JEJacobi/divchrono/doc/encoder.odt

Encoder Board

Simple board mounted forwards on the front side of the case, four mounting holes with standoffs to sit right up against the case. Rotary switch at the center. Seven positions, which are encoded into 3 bits of data using a SN74HC148DR.

Output Specification:

P1 | P2 | P3 | P4 | P5 | P6 | P7 | D1 | D2 | D3
1 / ? | 1 / ? | 1 / ? | 1 / ? | 1 / ? | 1 / ? | 1 / ? | 1 | 1 | 1
1 | 1 | 1 | 1 | 1 | 1 | 0 | 0 | 0 | 0
1 | 1 | 1 | 1 | 1 | 0 | 1 | 1 | 0 | 0
1 | 1 | 1 | 1 | 0 | 1 | 1 | 0 | 1 | 0
1 | 1 | 1 | 0 | 1 | 1 | 1 | 0 | 0 | 1
1 | 1 | 0 | 1 | 1 | 1 | 1 | 1 | 1 | 0
1 | 0 | 1 | 1 | 1 | 1 | 1 | 1 | 0 | 1
0 | 1 | 1 | 1 | 1 | 1 | 1 | 0 | 1 | 1

P 1, 2, 3, 4, 5, 6, 7: Inputs from the rotary switch, corresponding to the seven possible connected states.

?: Unknown state, or no valid reading from the rotary switch (such as the switch being disconnected while in travel).

D1, D2, D3: Encoded output data, fed to the raspi for mode processing.
