JEJacobi/divchrono/doc/cables.odt

Cables

Case:

- RASPI to MASTER: 2x13 pin female to female, see BOM.
- MASTER to DISPLAY: 2x6 pin IDC ribbon cable for data. Copy off of Titor’s design, add four pins for pushbutton feedback (pulled up to 3.3v on the master board).
- MASTER to ENCODER: 2x3 pin ribbon cable, standard AVR programming style 2x3 headers. D1, D2, D3, +3.3v, GND. One pin unused.

External:

- 12V POWER to CASE: Standard barrel jack connector to provide main power to case.
- 12V POWER to AMPLIFIER: Splitter off of the 12V power supply will power the external amplifier.
- RASPI AUDIO to AMPLIFIER: A 3.5mm port at the back of the case will connect to the external amplifier.
- AMPLIFIER to SPEAKERS or TRANSDUCERS: The 3.5mm or terminal block output ports on the external amplifier will connect to any desired audio sinks.
