JEJacobi/divchrono/doc/display.odt

Display

The upper display board contains eight IN-14 nixie tubes, as well as three HV5622 driver chips. A ribbon cable provides +170VDC, +12VDC, GND * 2, DAT, CLK, LAT, and BLANK connections, along with four contacts for the four pushbuttons mounted at the top of the case.

The original schematic of this board is based on seems to contain an error, as the HV5622 chips’ recommended logic voltage is between 10.8V and 13.2V. The schematic shows a logic supply voltage of +5VDC, and a connection directly to the 5V powered microcontroller.

This version of the HV5622 signals will have a single direction 3.3V → 12V level converter, with a 3904 connected to the Pi via a 10k current limiting resistor, and a 10k pull-up resistor. On the other end, a 4.7k holds the data lines high, with the Pi pulling them to ground by sinking the signal transistor’s pull-up.

The four pushbuttons at the top of the case are pulled down to ground by a press, and are normally pulled up high with 10k resistors on the master board.

Dimming will be accomplished through software PWM on the blanking pin.
