JEJacobi/divchrono/doc/pins.odt

Pin Mapping

Name | Description | Pin | BCM Port
STATUS_DAT | Status LEDs’ shift register data pin. | 11 | 17
STATUS_CLK | Status LEDs’ shift register clock pin. | 13 | 27
STATUS_LAT | Status LEDs’ shift register latch pin. | 7 | 4
DISPLAY_DAT | Display board Nixie shift registers’ data pin. | 16 | 23
DISPLAY_CLK | Display board Nixie shift registers’ clock pin. | 18 | 24
DISPLAY_LAT | Display board Nixie shift registers’ latch pin. | 10 | 15
DISPLAY_BLANK | PWM brightness control pin for the Nixie tube display. | 12 | 18
BUTTON_LEFT | Status of the ‘<’ pushbutton, active low. | 15 | 22
BUTTON_RIGHT | Status of the ‘>’ pushbutton, active low. | 19 | 10
BUTTON_UP | Status of the ‘+’ pushbutton, active low. | 21 | 9
BUTTON_DOWN | Status of the ‘-’ pushbutton, active low. | 23 | 11
ENCODER_D1 | Pin #1 for the encoded position of the main rotary switch. | 22 | 25
ENCODER_D2 | Pin #2 for the encoded position of the main rotary switch. | 24 | 8
ENCODER_D3 | Pin #3 for the encoded position of the main rotary switch. | 26 | 7

Sources:

- https://pinout.xyz
- https://www.raspberrypi.org/documentation/hardware/raspberrypi/schematics/Raspberry-Pi-Rev-2.1-Model-AB-Schematics.pdf
