JEJacobi/divchrono/doc/power.odt

Power Management

Main board power is provided through a board mounted barrel connector on the far left side of the unit. It inputs 12VDC from a T1116-P5P (or similar) power supply unit. The 12VDC is used directly by the audio amplifier module, and is also fed into two other power management modules for logic step-down, and Nixie tube step-up.

The 12VDC is stepped down to 5VDC through a TI TPS562200DDCR switching buck converter, capable of handling up to 2A. The Raspberry Pi will consume around 1.4A given its fairly light load of USB modules, and the rest of the logic circuits should use less than 100mA combined, giving a 25% power safety margin. See datasheet for example circuit, and schematic for exact parts and layout.

To provide high voltage DC for the Nixie tubes, the 12VDC is also fed into the ‘1364 - SmartNixie HVPS-H’ module, which provides up to 8 watts of power given 12V in. This module is mounted on the master board.
