JEJacobi/divchrono/doc/status.odt

Status LEDs

Name | Description | Number
PWR | Enabled at program startup, signals that the Pi’s software is running. | 0
HEARTBEAT | LED is toggled every second to indicate that the software is in working order. If something locks up or the software crashes, this will stop blinking. | 1
RTC OK | Enabled if good data and checksums are received from the Real Time Clock on the auxiliary board. | 2
NTP OK | Enabled if NTP (clock synchronization) server can be reached. | 3
NET OK | Enabled if the internet can be reached (ping results?). | 4
ALARM | Enabled if the ALARM mode is set. | 5
AUDIO | Enabled if the Pi is currently playing audio. | 6
UNUSED | Currently not used. | 7
