JEJacobi/divchrono/doc/amplifier.odt

Amplifier Board

Due to the Raspi’s analog audio out being a very weak audio source (since it’s just PWM filtered through a low-pass filter), audio output will be buffered through this board before being fed into speakers or transducers.

The amplifier is a simple 5x5cm PCB with a 12V barrel port, a 3.5mm audio in port, a 3.5mm audio out port, and a 3 pin terminal block for directly wiring to speakers.

The amplifier has a small gain trim potentiometer, but any real amplification should be done further down the signal path. Additionally, the amplifier has a 2 pin shunt that, when closed, will play mono audio (in case only one speaker is connected).
