JEJacobi/divchrono/doc/master.odt

Master Board

The master board is a large (10x10?) board that acts as the supervisor for the Raspi, Display, Auxiliary, and Encoder boards. It contains two power supply modules (see Power) that step 12VDC to 5VDC and 170VDC. The board also has a 8 LED status readout (see Status) at the back of the case, cable jacks for connections to the Raspi, Display, and Encoder boards.

See each section’s documentation for more detail.
