JEJacobi/divchrono/doc/auxiliary.odt

Auxiliary Board

The auxiliary board is a small (5x5cm) board that sits directly on top of the raspi’s GPIO header, and provides a stacking connection to the master ↔ raspi ribbon through an extra-long female header. Power and data lines are shared with the raspberry pi, and it requires no external connections.

The board has four main sections, the RTC IC, a 4 pin I2C jack for an HTU21D temperature/humidity sensor breakout board, a CR2032 battery holder, and two status lights for the RTC/battery status.

The PCF85263AT/AJ RTC provides an I2C-connected battery-backed real time clock to the raspberry pi, either as a primary time source or as a fallback if NTP fails. It has a status LED connected to it, which can function in a variety of modes depending on the INTA pin configuration.

Additionally, a comparator provides a low-voltage battery warning should the backup battery fall below 2.5 volts. This is fed to the LOW BATTERY status LED.
