JEJacobi/divchrono/doc/modes.odt

Master Modes

The seven position rotary switch allows the selection of seven different modes. Each mode assigns different functions to the four pushbuttons located at the top of the unit. The raspberry pi handles all processing and logic functions for the modes.

Mode details, in clockwise order beginning from the bottom leftmost position:

POSITION 1: OFF

The clock is shut off. The board and raspi remain powered on, but the nixie tubes are shut down, and no sound is played. The pushbuttons are not mapped to anything in this mode.

POSITION 2: CLOCK

The nixie tubes are enabled and display the current time in either 12/24 hour mode, depending on the configuration file’s setting. The pushbuttons change the display between current time, day of week, and day/month/year.

POSITION 3: ALARM

Identical to the previous mode, but a daily alarm is enabled at a stored time. When the time is reached, a random audio track is played out of a folder, and continues until this mode is disabled. The +/- pushbuttons set the alarm time, and the </> pushbuttons set the specified volume percentage in steps of 10%. A change to the alarm time will change the tubes to display this new value for a few seconds, before reverting to the 24 hour time. Similarly, a change to the volume will display the new percentage for a few seconds before reverting.

POSITION 4: DIVERGE

???

POSITION 5: MUSIC

In this mode, the tubes display the currently selected track, and the total number of valid tracks in the folder. Similarly to the alarm mode, the </> sets the volume, and +/- controls the currently selected track. Tracks play sequentially, and loop until the mode is disabled. A change in volume will momentarily change the display to reflect the new setting, as in ALARM mode.

POSITION 6: STATUS

In this mode, the tubes display the varying statuses:

- Current ambient temperature.
- Current ambient humidity.
- Uptime in seconds.
- Current IP, if connected.
- MAC address.

POSITION 7: EDIT

This mode lets you set the currently active date and time. </> control the active setting, and +/- change the value. The longer +/- are held, the more the value changes.

Settings:

- Seconds
- Minutes
- Hours
- Day of month
- Month
- Year
- Timezone
- DST (?)
