JEJacobi/divchrono/hw/divchronoBOM_rev1.ods

Divergence Chronometer BOM
Ref | Value | Footprint | Notes
MAIN BOARD
C1 | 100uF | E2,5-6
C2 | 470uF | E2,5-6
C3, C6, C9, C10, C12, C13 | 100nF | C1206
C4 | 10uF | E2-5
C5 | 10uF | C1206
C7, C8 | 22uF | C1206
C11 | 330uF | E3,5-8
D1, D2, D3, D4, D5, D6, D7, D8 | LTST-C230KRKT | LED1206
J1 | PJ-202AH | SPC4077
J2 | PINHD-2X13 MALE | 2X13
J3 | PINHD-2X6 MALE | 2X06
J4 | PINHD-2X3 MALE | 2X03
JP1 | PINHD-1X2 MALE | 1X02
L1 | 4.7uH | BS11
Q1, Q2, Q3, Q4 | BSS138 | SOT23-3
R1, R6, R7, R8, R9, R18, R19, R20, R21, R22, R23, R24, R25 | 10k | R1206
R2 | 56k 1% | R1206
R3 | 10k 1% | R1206
R4 | 100k | R1206
R5 | 47k | R1206
R10, R11, R12, R13, R14, R15, R16, R17 | 1k | R1206
U1 | TPS562200DDCR | SOT95P280X110-6N
U2 | HVPS 1364 | “ | See TES library
U3 | SN74HC595D | SOIC-16
DISPLAY BOARD
TODO
AUXILIARY BOARD
B1 | PRT-00783 | BATTERY20PTH
C1, C2, C3, C4 | 100nF | C1206
D1, D2 | LTST-C230KRKT | LED1206
J1 | PINHEAD-2X13 | 2X13
J2 | PINHEAD-1X4 | 1x04
J3 | PINHEAD-1X2 | 1x02
R1, R2 | 4.7k | R1206
R3, R7 | 10M | R1206
R6, R8 | 2.2k | R1206
R4 | 15k | R1206
R5 | 47k | R1206
U1 | PCF85263AT/AJ | SOIC-8
U2 | MIC7221YM5 | SOT23-5
X1 | AB38T | WATCH-3X8
ENCODER BOARD
C1, C2 | 100nF | C1206
J1 | PINHEAD-2X3 | 2X03 | Get AVR programming-style cable for connecting to main board.
R1, R2, R3, R4, R5, R6, R7 | 1M | R1206
S1 | CKN10616 | CKN10616 | Compatible with similar solder lug (?) SP7T C&K models.
U1 | SN74HC148D | SOIC-16
MISC PARTS
RASPI HEAT SINK | https://www.adafruit.com/products/3084 |  | Needs to be thin enough to fit the peripherals on top of the header.
RASPI GPIO RIBBON CABLE | https://www.adafruit.com/product/862 |  | Hopefully long enough to reach the header on the main board.
RASPI GPIO STACKING HEADER | https://www.adafruit.com/products/1112 |  | Stacking header for mounting the peripherals board on.
8 OHM 0.5 WATT SPEAKER * 2 | https://www.sparkfun.com/products/9151 |  | Standard speakers for amp testing/use.
COIN CELL BATT HOLDER 20MM PTH | https://www.sparkfun.com/products/783 |  | Coin cell holder for aux board.
