JEJacobi/divchrono/doc/setup.odt

Setup

Username: root

Password: diverge

Make a new image:

1. Flash new minibian image to SD card.
2. Run a full upgrade ( apt-get update && apt-get dist-upgrade ).
3. Install git and the raspi-config utility using: apt-get install git raspi-config.
4. Expand the SD card and activate the I2C bus using the raspi-config utility.
5. Clone the 'divchrono' repository from github using: git clone https://github.com/JEJacobi/divchrono.git
6. cd into the divchrono directory.
7. If it isn't already, set the install.sh file as executable with chmod +x install.sh
8. Run the installer script: ./install.sh
