JEJacobi/divchrono/doc/divchrono-encoder_rev1.pdf

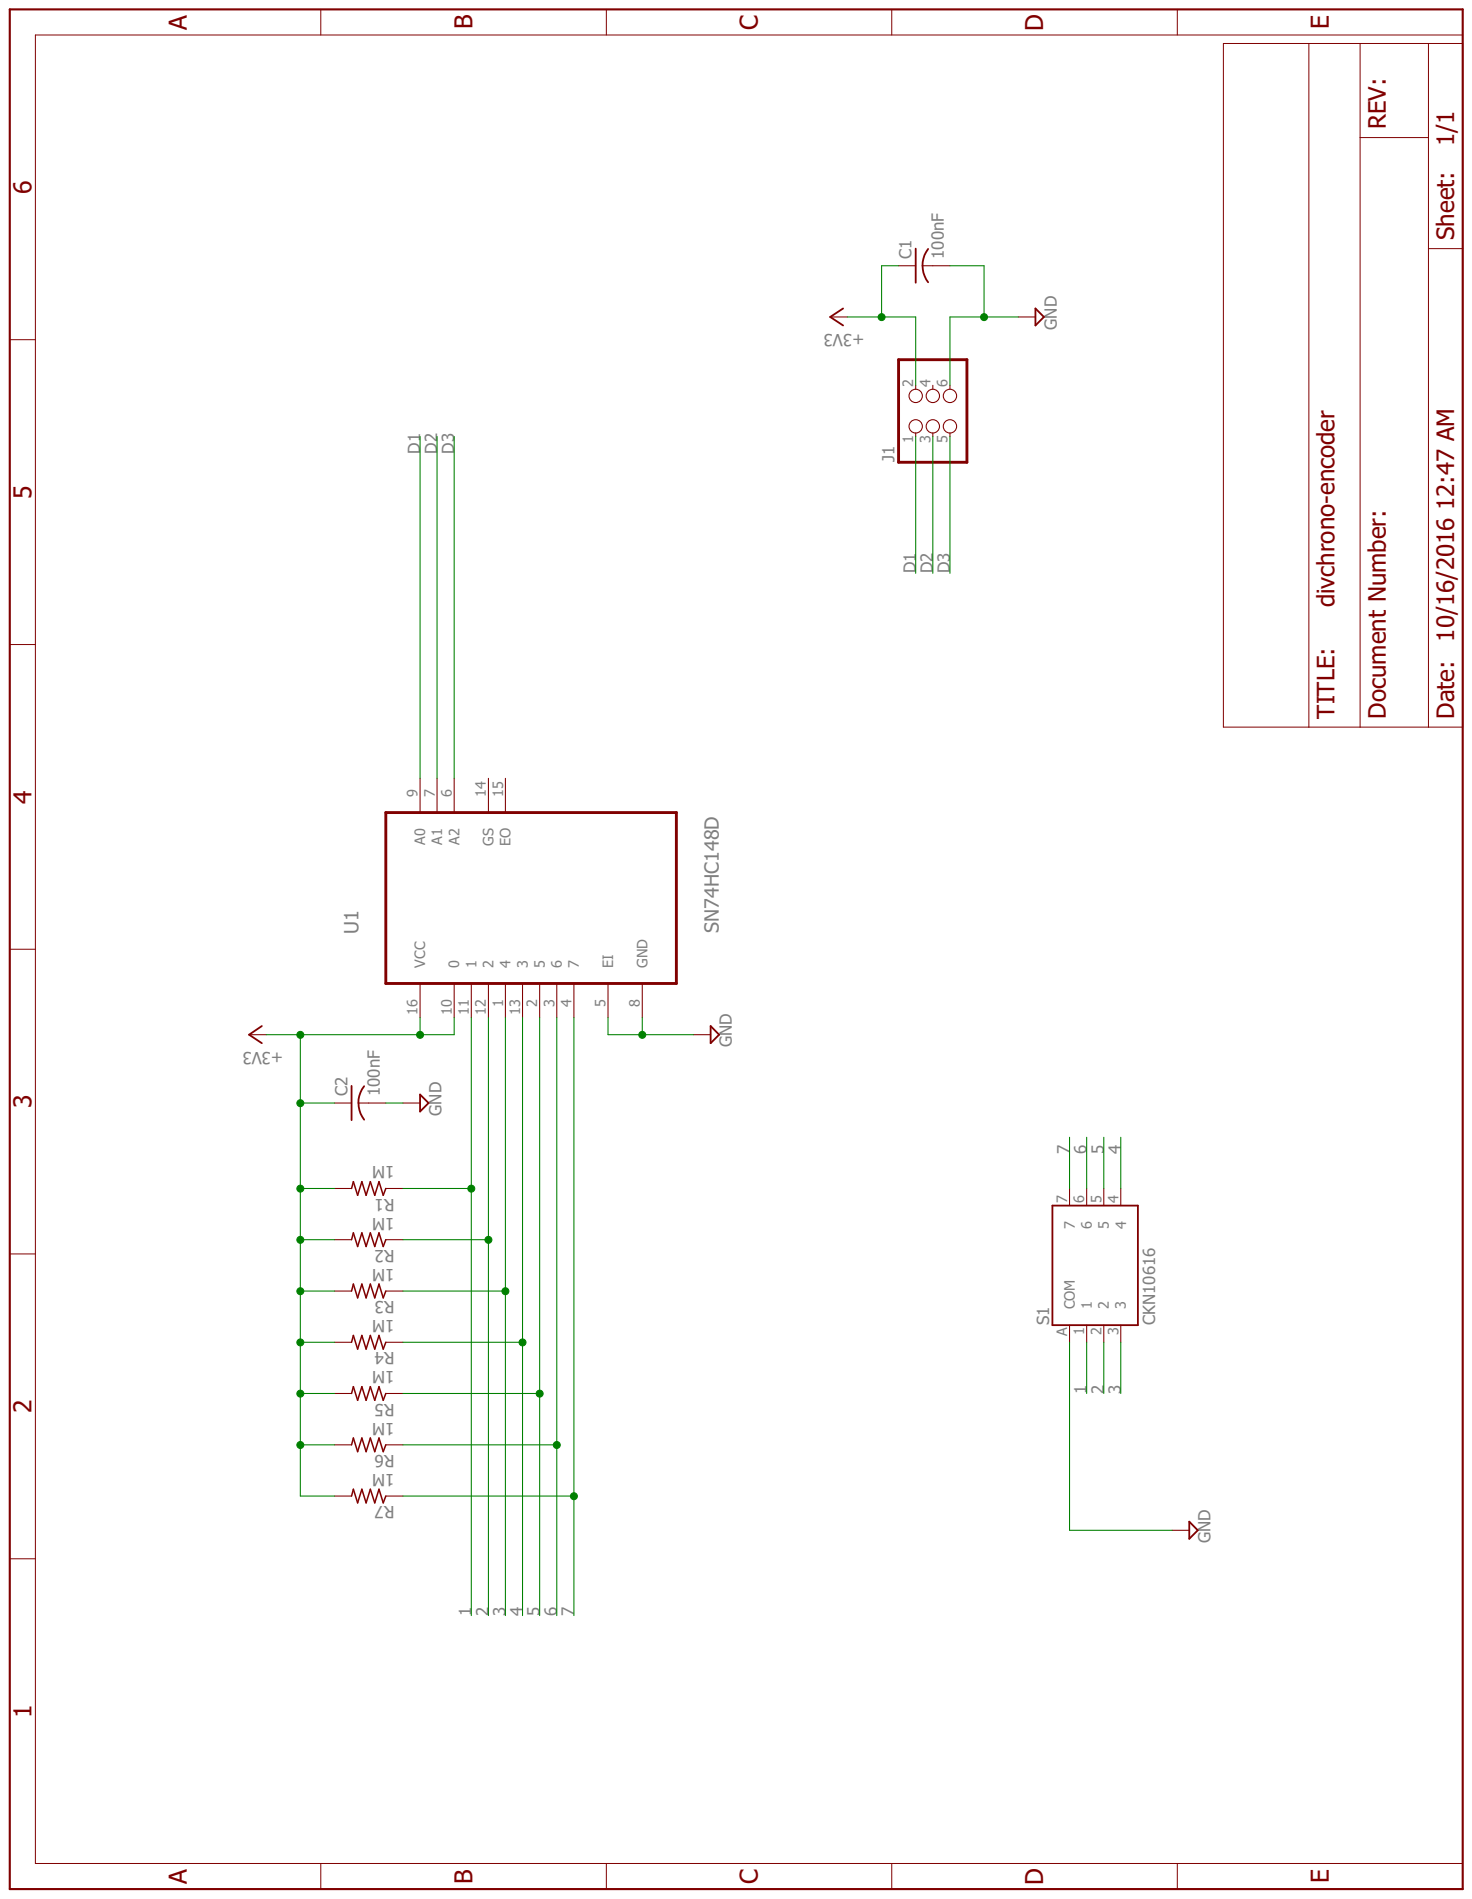
[picture p1: page 1]

100nF 3V3 + GND SN74HC148D GND 3V3 + 100nF GND M1M1M1M1M1M1M1 CKN10616 GND J1 1 2 3 4 5 6 C1 VCC 16 0 10 1 11 2 12 4 1 3 13 5 2 6 3 7 4 EI 5 GND 8 A0 9 A1 7 A2 6 GS 14 EO 15 U1 C2 1R2R3R4R5R6R7R COM A 1 1 2 2 3 3 4 4 5 5 6 6 7 7 S1 D1 D1 D2 D2 D3 D3 1 1 2 2 3 3 4 4 5 5 6 6 7 7 ABCDE ABCDE 1 2 3 4 5 6 Date: 10/16/2016 12:47 AM Sheet: 1/R1EV: TITLE: Document Number: divchrono-encoder
