JEJacobi/divchrono/doc/divchrono-master_rev1.pdf

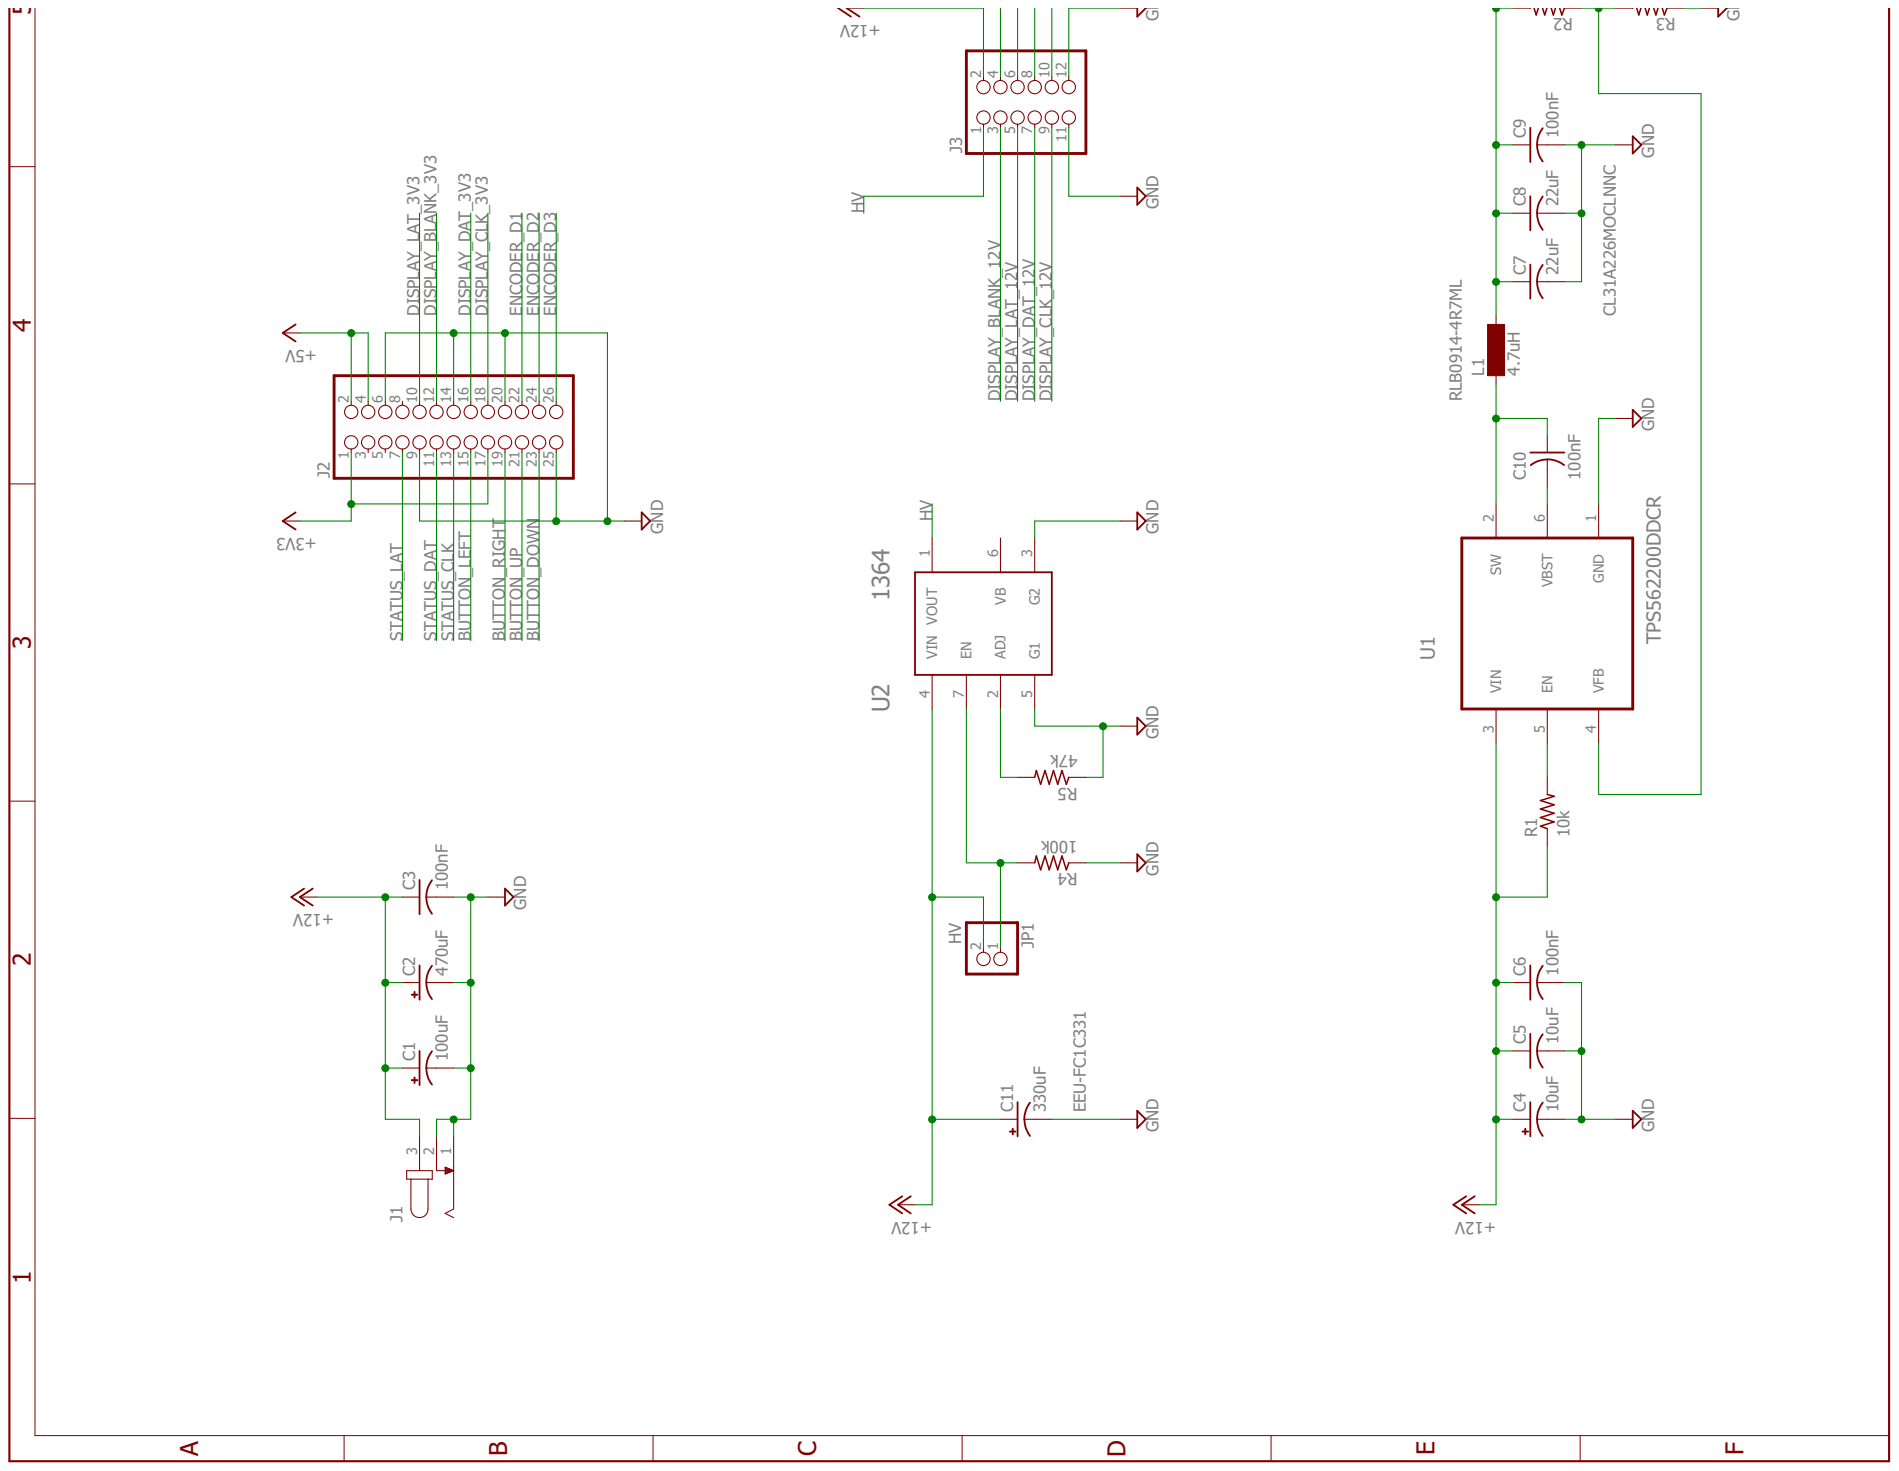
[picture p2: page 1]

CL31A226MOCLNNC RLB0914-4R7ML EEU-FC1C331 100uF 470uF 100nF GND V21 + TPS562200DDCR 10uF 10uF 100nF V21 + GND 10k 22uF 22uF 100nF GND GND 4.7uH 100nF %1 k65 %1 k01 GND V5 + 1364 GND GND 330uF GND V21 + HV k001 GND k74 GND V5 + 3V3 + 3V3 + GND 100nF V21 + GND GND k01 k01 k01 k01 3V3 + 74HC595D 3V3 + GND 100nF 1k1k1k1k1k1k1k1k GND 3V3 + GND BSS138 BSS138 k01 k01 k01 k01 3V3 + 3V3 + V21 + V21 + BSS138 BSS138 k01 k01 k01 k01 3V3 + 3V3 + V21 + V21 + J1 321 C1 C2 C3 VIN 3 SW 2 EN 5 VFB 4 GND 1 VBST 6 U1 C4 C5 C6 R1 C7 C8 C9 L1 C10 2R 3R VIN 4 EN 7 G1 5 VOUT 1 VB 6 G2 3 ADJ 2 U2 C11 JP1 21 4R5R J2 1 2 3 4 5 6 7 8 9 10 11 12 13 14 15 16 17 18 19 20 21 22 23 24 25 26 J4 1 2 3 4 5 6 C12 J3 1 2 3 4 5 6 7 8 9 10 11 12 6R7R8R9R U3 QB 1 QC 2 QD 3 QE 4 QF 5 QG 6 QH 7 SCL 10 SCK 11 RCK 12 G 13 SER 14 QA 15 QH* 9U3CCV PDNG 61 8 C13 D1D2D3D4D5D6D7D8 R10 R11 R12 R13 R14 R15 R16 R17 Q1 Q2 81R 91R 02R 12R Q3 Q4 22R 32R 42R 52R HV HV STATUS_DAT STATUS_DAT STATUS_LAT STATUS_LAT STATUS_CLK STATUS_CLK DISPLAY_DAT_3V3 DISPLAY_DAT_3V3 DISPLAY_CLK_3V3 DISPLAY_CLK_3V3 ENCODER_D1 ENCODER_D1 DISPLAY_BLANK_3V3 DISPLAY_BLANK_3V3 BUTTON_LEFT BUTTON_LEFT BUTTON_RIGHT BUTTON_RIGHT BUTTON_UP BUTTON_UP BUTTON_DOWN BUTTON_DOWN ENCODER_D2 ENCODER_D2 ENCODER_D3 ENCODER_D3 DISPLAY_LAT_3V3 DISPLAY_LAT_3V3 DISPLAY_BLANK_12V DISPLAY_BLANK_12V DISPLAY_LAT_12V DISPLAY_LAT_12V DISPLAY_DAT_12V DISPLAY_DAT_12V DISPLAY_CLK_12V DISPLAY_CLK_12V ABCDEF ABCDEF 1 2 3 4 5 6 7 8 9 Date: 10/23/2016 4:15 PM Sheet: 1/R1EV: TITLE: Document Number: divchrono-master

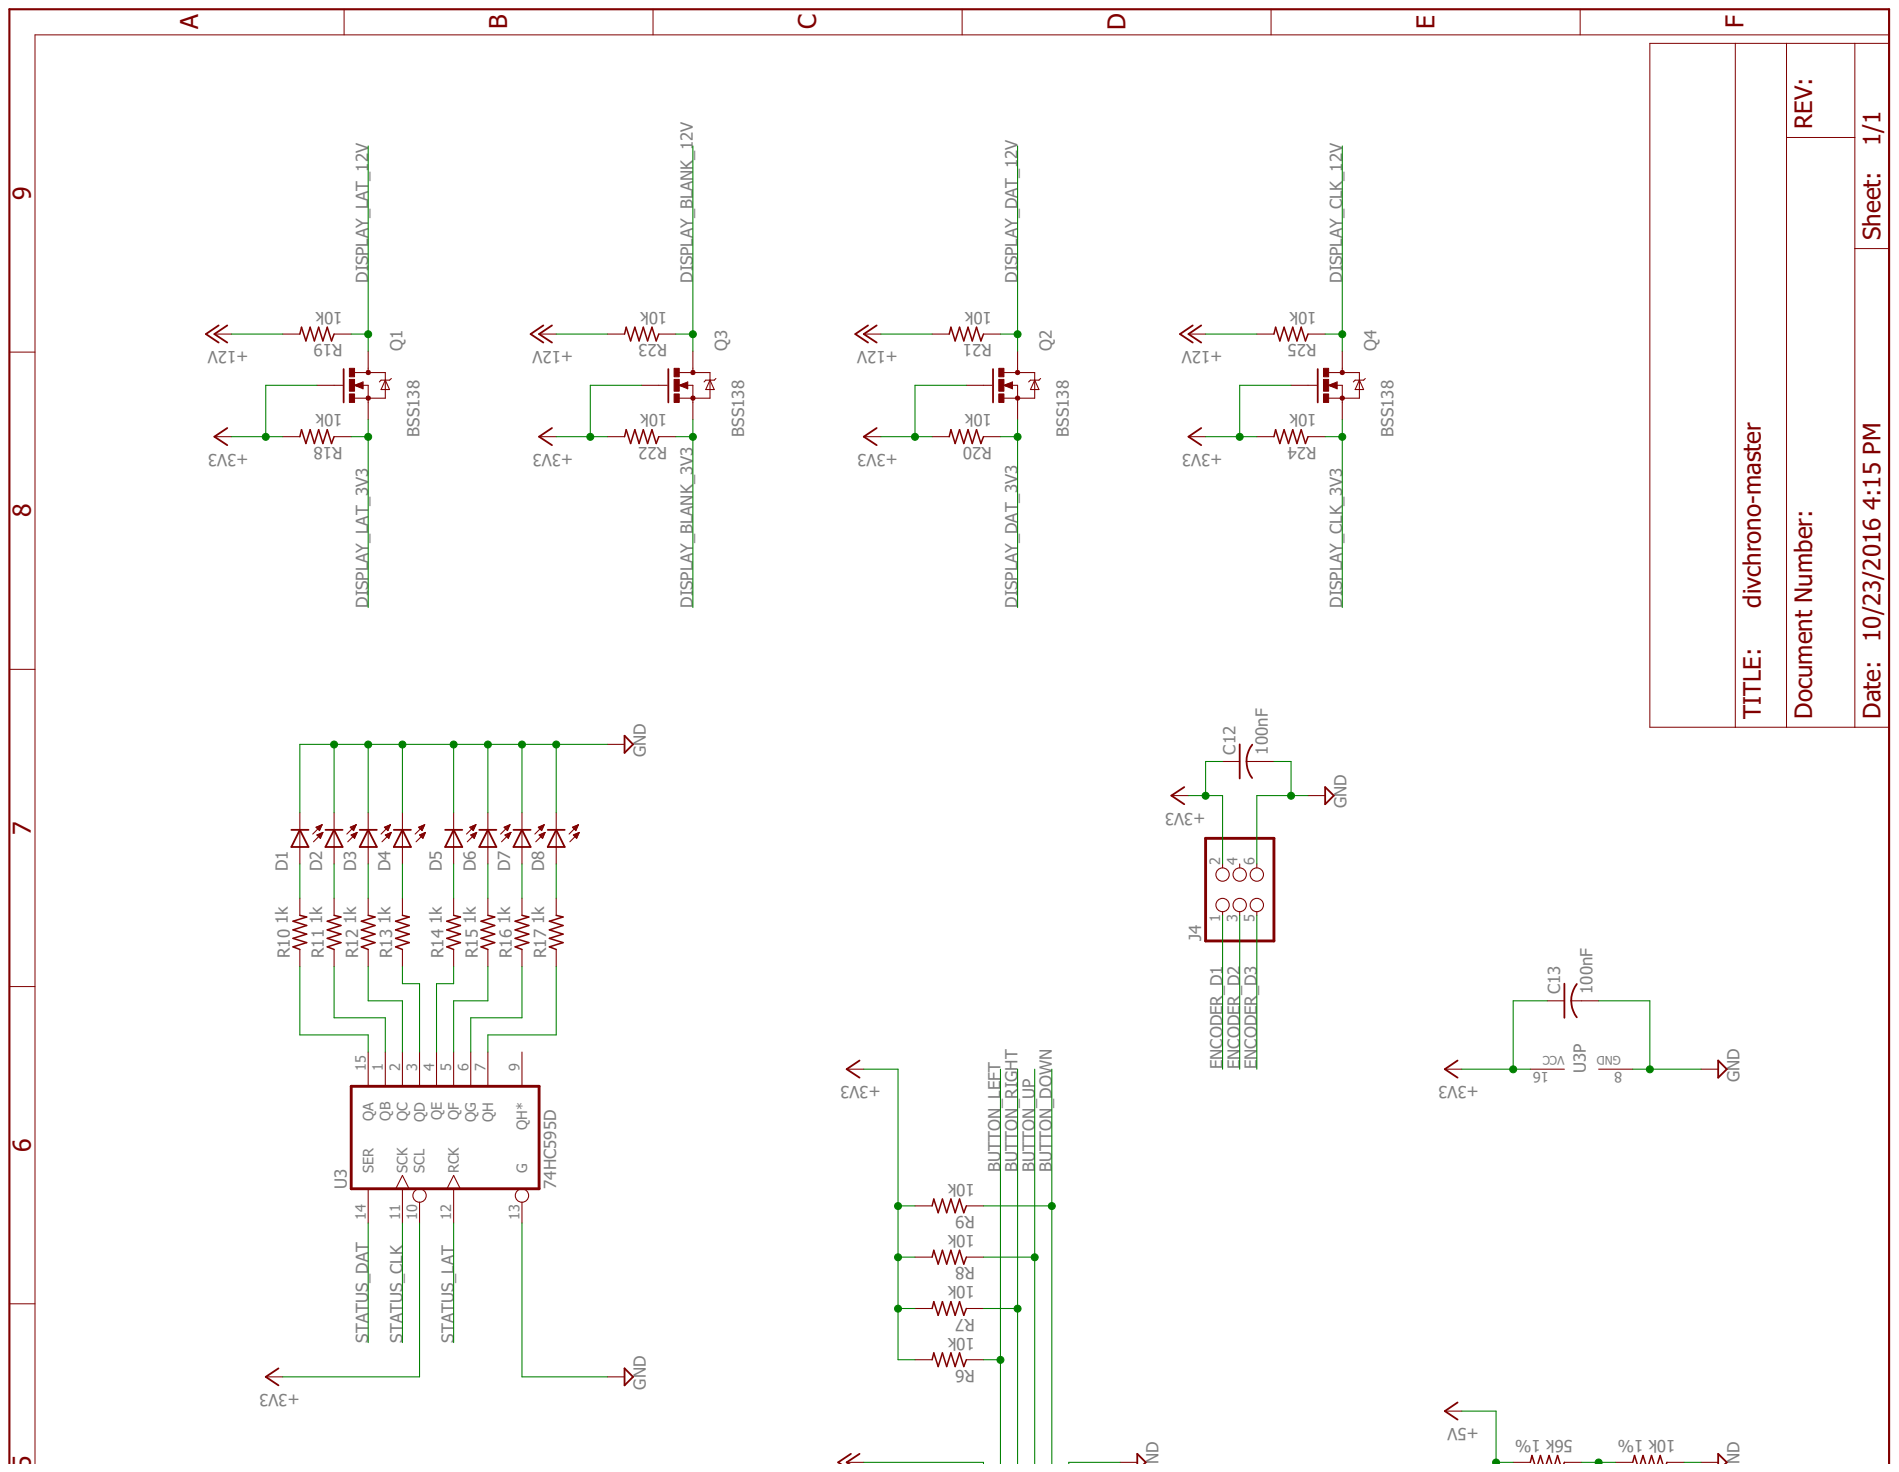
[picture p3: page 2]
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
