JEJacobi/divchrono/doc/divchrono-aux_rev1.pdf

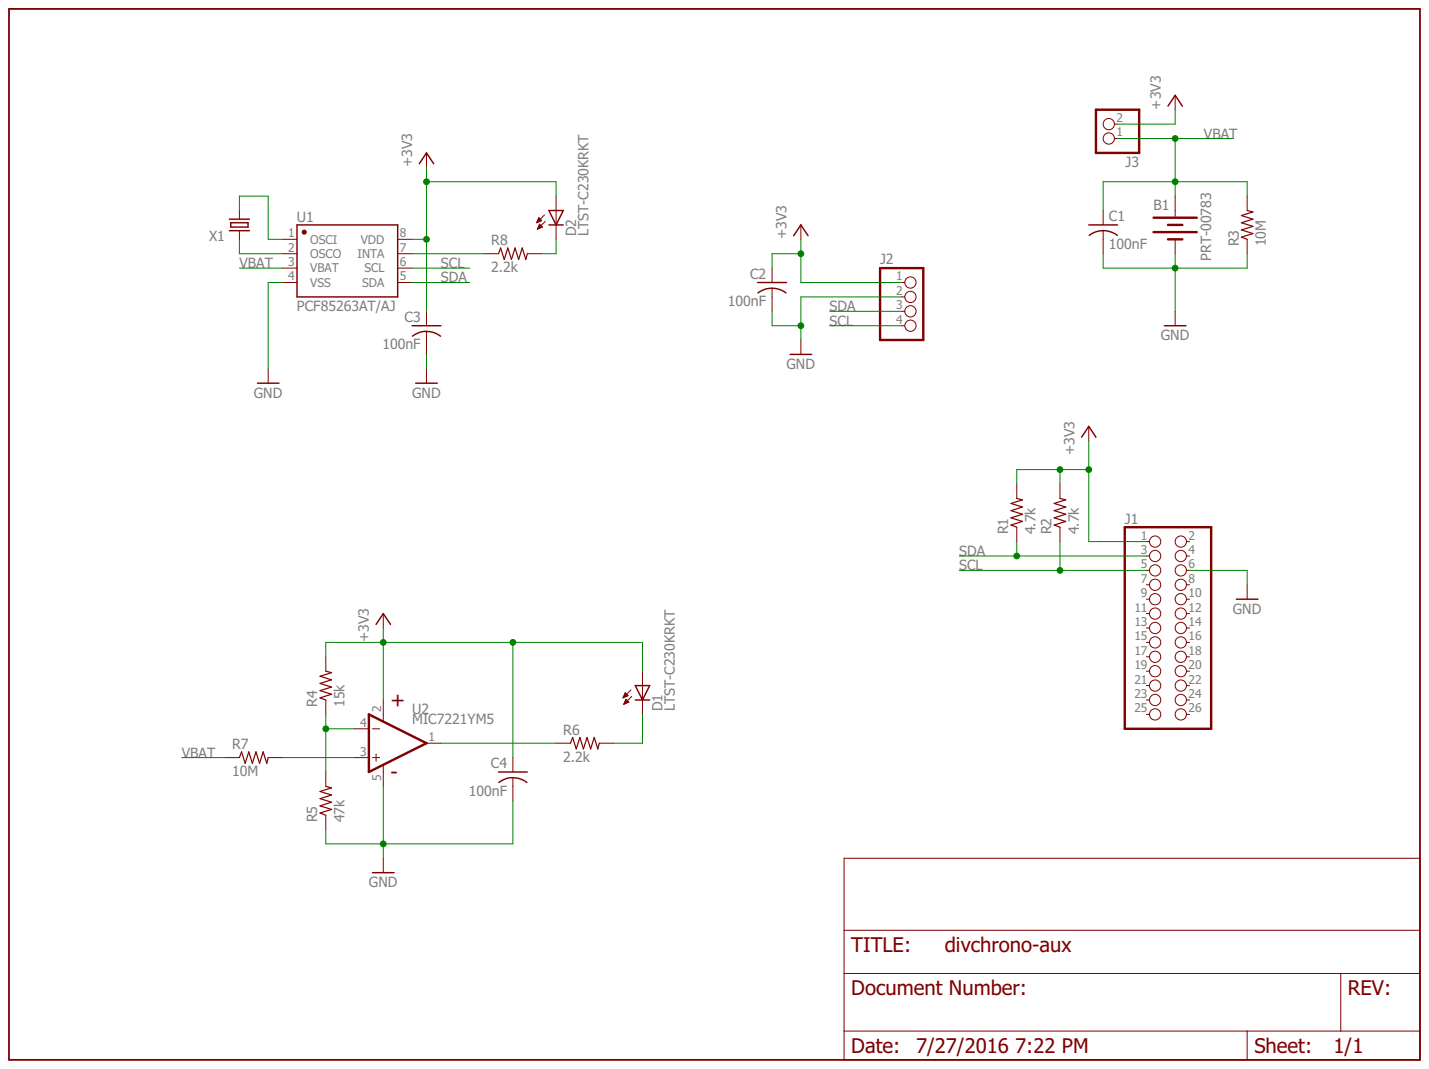
[picture p4: page 1]

Document Number: | REV:

Date: 7/27/2016 7:22 PM | Sheet: 1/1
