JEJacobi/divchrono/hw/divchrono-master.brd

## EAGLE design hw/divchrono-master.brd (2016-10-24)

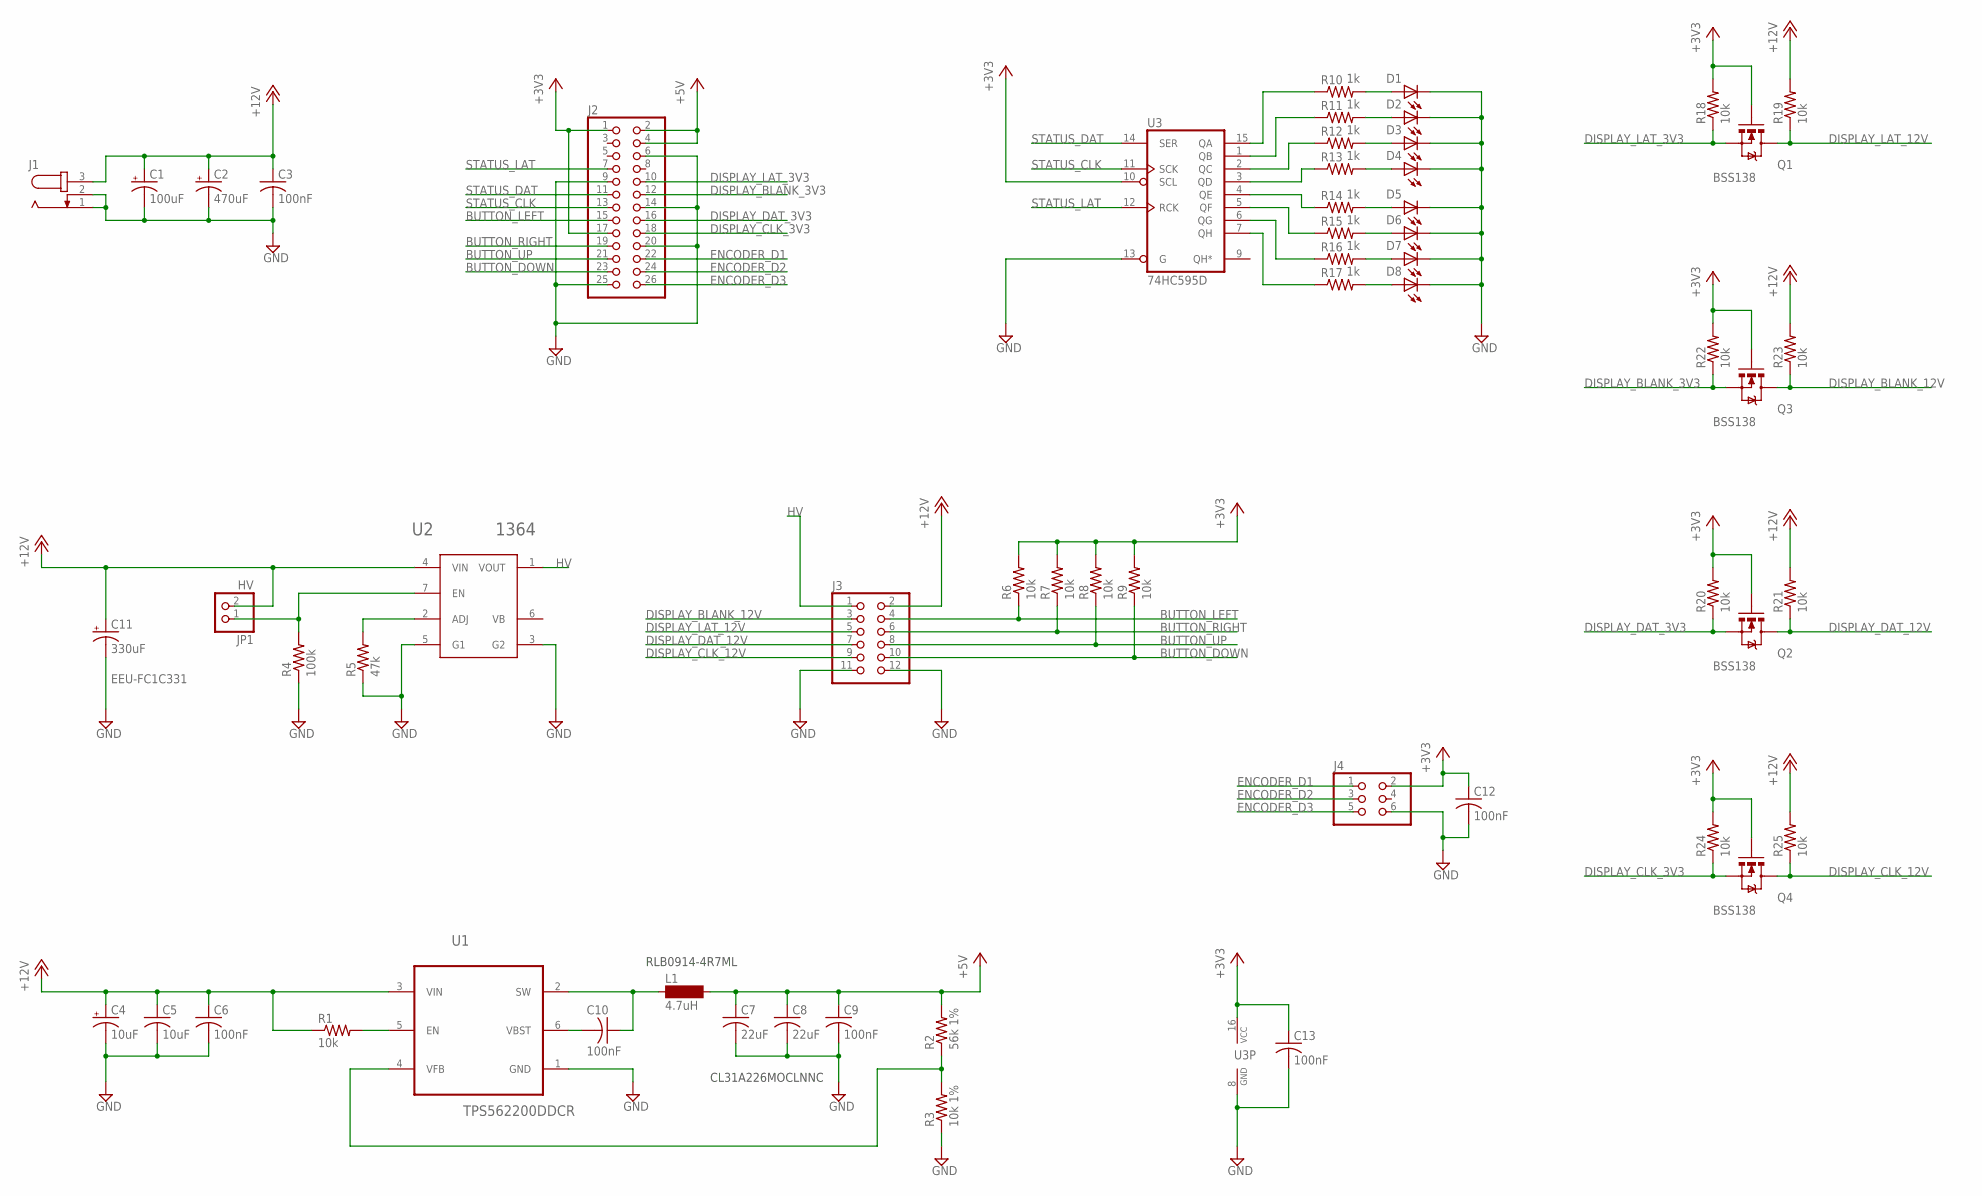
[picture p5: schematic divchrono-master.sch]

Parts:
C1: 100uF; E2,5-6
C2: 470uF; E2,5-6
C3, C6, C9, C10, C12, C13: 100nF; C1206
C4: 10uF; E2-5
C5: 10uF; C1206
C7, C8: 22uF; C1206
C11: 330uF; E3,5-8
D1, D2, D3, D4, D5, D6, D7, D8: LEDCHIPLED_1206; CHIPLED_1206
J1: JACK-PLUG0; SPC4077
J2: PINHD-2X13; 2X13
J3: PINHD-2X6; 2X06
J4: PINHD-2X3; 2X03
JP1: HV; 1X02
L1: 4.7uH; BS11
Q1, Q2, Q3, Q4: BSS138; SOT23-3
R1, R6, R7, R8, R9, R18, R19, R20, R21, R22, R23, R24, R25: 10k; R1206
R2: 56k 1%; R1206
R3: 10k 1%; R1206
R4: 100k; R1206
R5: 47k; R1206
R10, R11, R12, R13, R14, R15, R16, R17: 1k; R1206
U1: TPS562200DDCR; SOT95P280X110-6N
U2: 1364
U3: 74HC595D; SO16

Connections:
+3V3: C12.1, C13.1, J2.1, J2.17, J4.2, Q1.1 (G), Q2.1 (G), Q3.1 (G), Q4.1 (G), R6.2, R7.2, R8.2, R9.2, R18.2, R20.2, R22.2, R24.2, U3.10 (SCL), U3.16 (VCC)
+5V: C7.1, C8.1, C9.1, J2.2, J2.4, L1.2, R2.2
+12V: C1.+, C2.+, C3.1, C4.+, C5.1, C6.1, C11.+, J1.3, J3.2, JP1.2, R1.1, R19.2, R21.2, R23.2, R25.2, U1.3 (VIN), U2.4 (VIN)
BUTTON_DOWN: J2.23, J3.10, R9.1
BUTTON_LEFT: J2.15, J3.4, R6.1
BUTTON_RIGHT: J2.19, J3.6, R7.1
BUTTON_UP: J2.21, J3.8, R8.1
DISPLAY_BLANK_3V3: J2.12, Q3.2 (S), R22.1
DISPLAY_BLANK_12V: J3.3, Q3.3 (D), R23.1
DISPLAY_CLK_3V3: J2.18, Q4.2 (S), R24.1
DISPLAY_CLK_12V: J3.9, Q4.3 (D), R25.1
DISPLAY_DAT_3V3: J2.16, Q2.2 (S), R20.1
DISPLAY_DAT_12V: J3.7, Q2.3 (D), R21.1
DISPLAY_LAT_3V3: J2.10, Q1.2 (S), R18.1
DISPLAY_LAT_12V: J3.5, Q1.3 (D), R19.1
ENCODER_D1: J2.22, J4.1
ENCODER_D2: J2.24, J4.3
ENCODER_D3: J2.26, J4.5
GND: C1.-, C2.-, C3.2, C4.-, C5.2, C6.2, C7.2, C8.2, C9.2, C11.-, C12.2, C13.2, D1.C, D2.C, D3.C, D4.C, D5.C, D6.C, D7.C, D8.C, J1.1, J1.2, J2.6, J2.9, J2.14, J2.20, J2.25, J3.11, J3.12, J4.6, R3.1, R4.1, R5.1, U1.1 (GND), U2.3 (G2), U2.5 (G1), U3.8 (GND), U3.13 (G)
HV: J3.1, U2.1 (VOUT)
unnamed: R1.2, U1.5 (EN)
unnamed: C10.1, L1.1, U1.2 (SW)
unnamed: JP1.1, R4.2, U2.7 (EN)
unnamed: R5.2, U2.2 (ADJ)
unnamed: C10.2, U1.6 (VBST)
unnamed: R2.1, R3.2, U1.4 (VFB)
unnamed: R14.1, U3.4 (QE)
unnamed: R13.1, U3.3 (QD)
unnamed: R12.1, U3.2 (QC)
unnamed: D8.A, R17.2
unnamed: D7.A, R16.2
unnamed: D6.A, R15.2
unnamed: D5.A, R14.2
unnamed: R11.1, U3.1 (QB)
unnamed: R10.1, U3.15 (QA)
unnamed: R15.1, U3.5 (QF)
unnamed: R16.1, U3.6 (QG)
unnamed: R17.1, U3.7 (QH)
unnamed: D4.A, R13.2
unnamed: D3.A, R12.2
unnamed: D2.A, R11.2
unnamed: D1.A, R10.2
STATUS_CLK: J2.13, U3.11 (SCK)
STATUS_DAT: J2.11, U3.14 (SER)
STATUS_LAT: J2.7, U3.12 (RCK)

Notes on the sheet:
EEU-FC1C331
CL31A226MOCLNNC
RLB0914-4R7ML

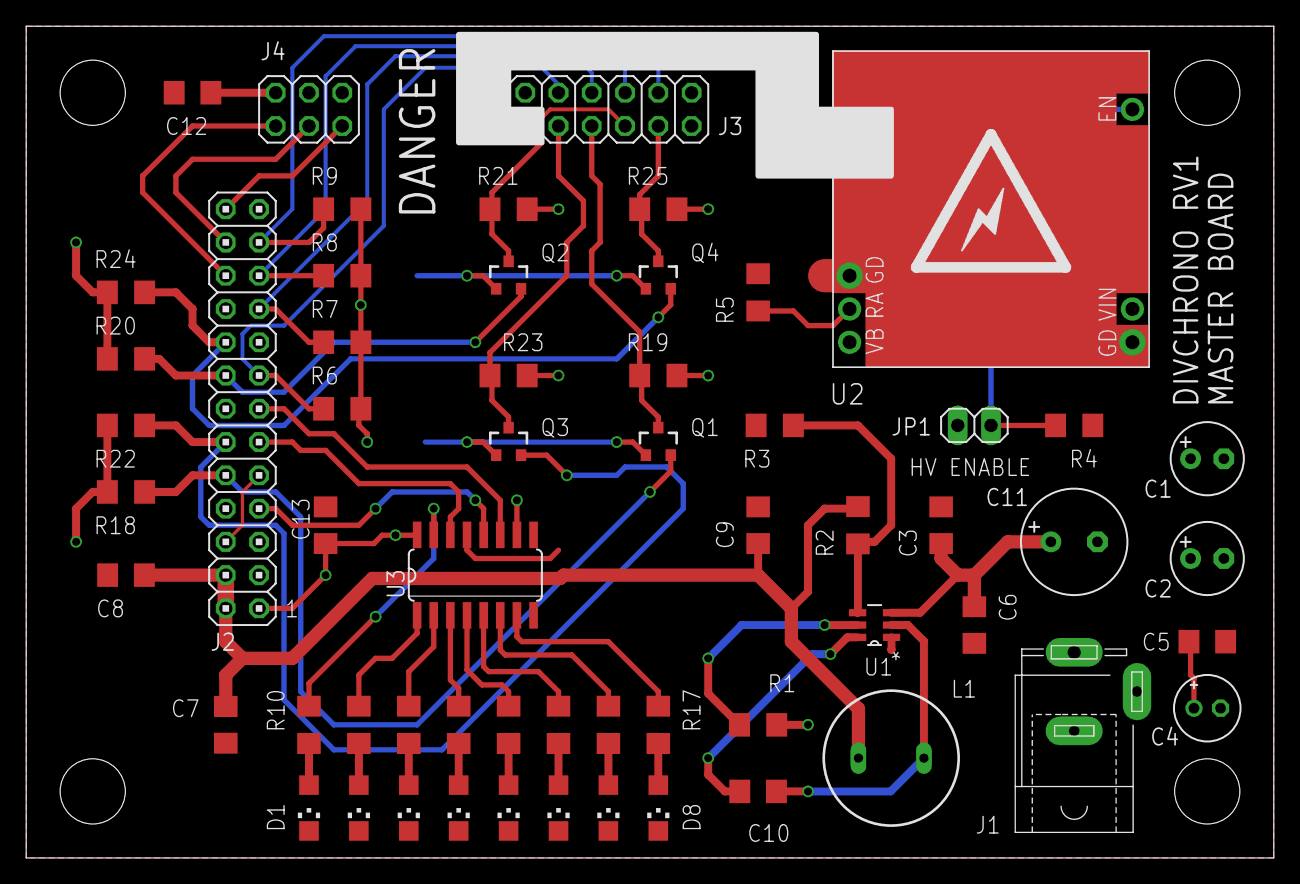
[picture p6: board divchrono-master.brd from above]

Board: 2 copper layers, 95.2 x 63.5 mm, 61 parts (1 on the bottom side), 45 nets.

Other parts of the board:
U$1: ICON_DANGER
U$2: ICON_BOLT-L
