JEJacobi/divchrono/hw/divchrono-encoder.brd

## EAGLE design hw/divchrono-encoder.brd (2016-10-17)

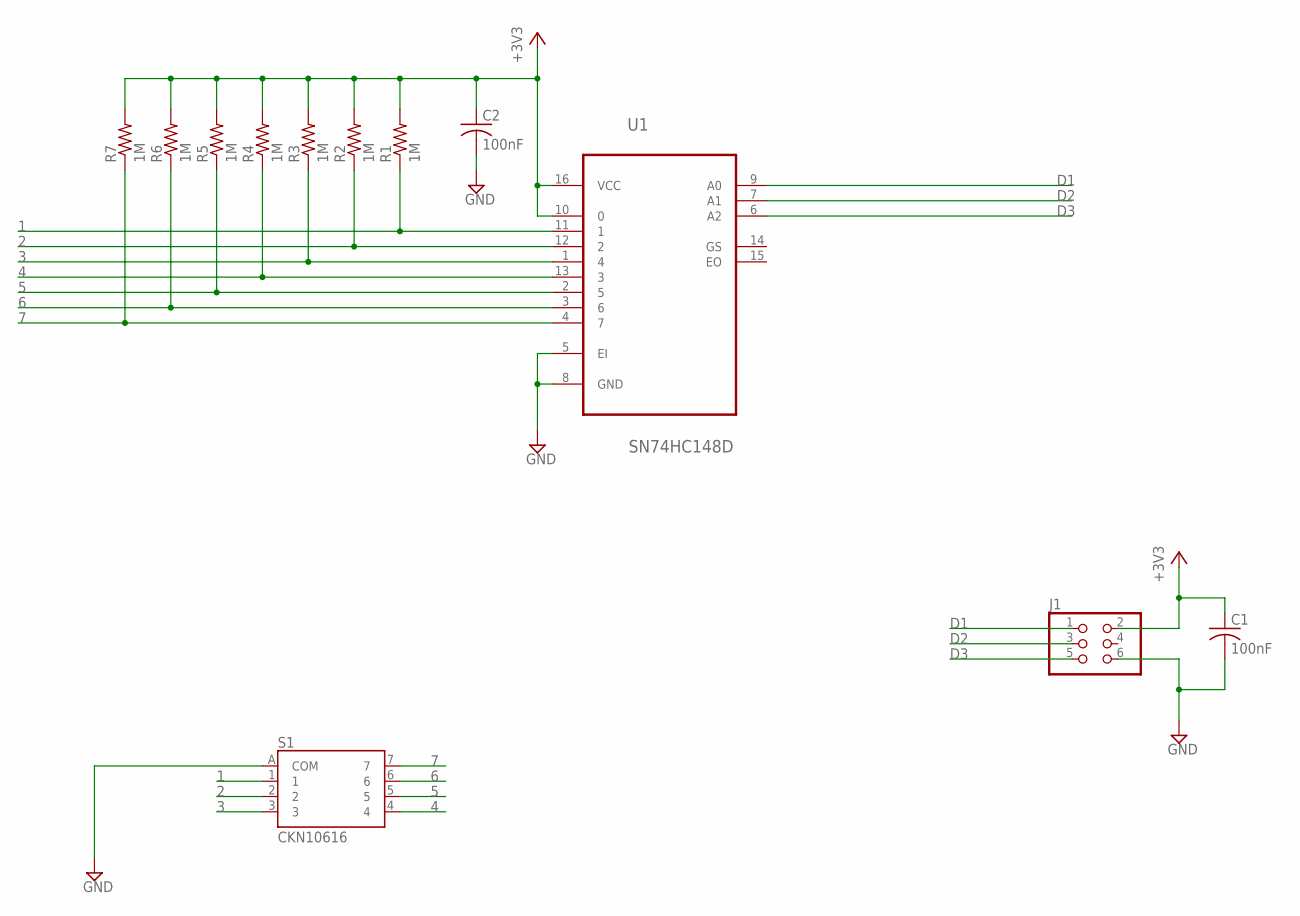
[picture p7: schematic divchrono-encoder.sch]

Parts:
C1, C2: 100nF; C1206
J1: PINHD-2X3; 2X03
R1, R2, R3, R4, R5, R6, R7: 1M; R1206
S1: CKN10616
U1: SN74HC148D; SOIC127P600X175-16N

Connections:
1: R1.1, S1.1, U1.11 (1)
2: R2.1, S1.2, U1.12 (2)
3: R3.1, S1.3, U1.1 (4)
4: R4.1, S1.4, U1.13 (3)
5: R5.1, S1.5, U1.2 (5)
6: R6.1, S1.6, U1.3 (6)
7: R7.1, S1.7, U1.4 (7)
+3V3: C1.1, C2.1, J1.2, R1.2, R2.2, R3.2, R4.2, R5.2, R6.2, R7.2, U1.10 (0), U1.16 (VCC)
D1: J1.1, U1.9 (A0)
D2: J1.3, U1.7 (A1)
D3: J1.5, U1.6 (A2)
GND: C1.2, C2.2, J1.6, S1.A (COM), U1.5 (EI), U1.8 (GND)

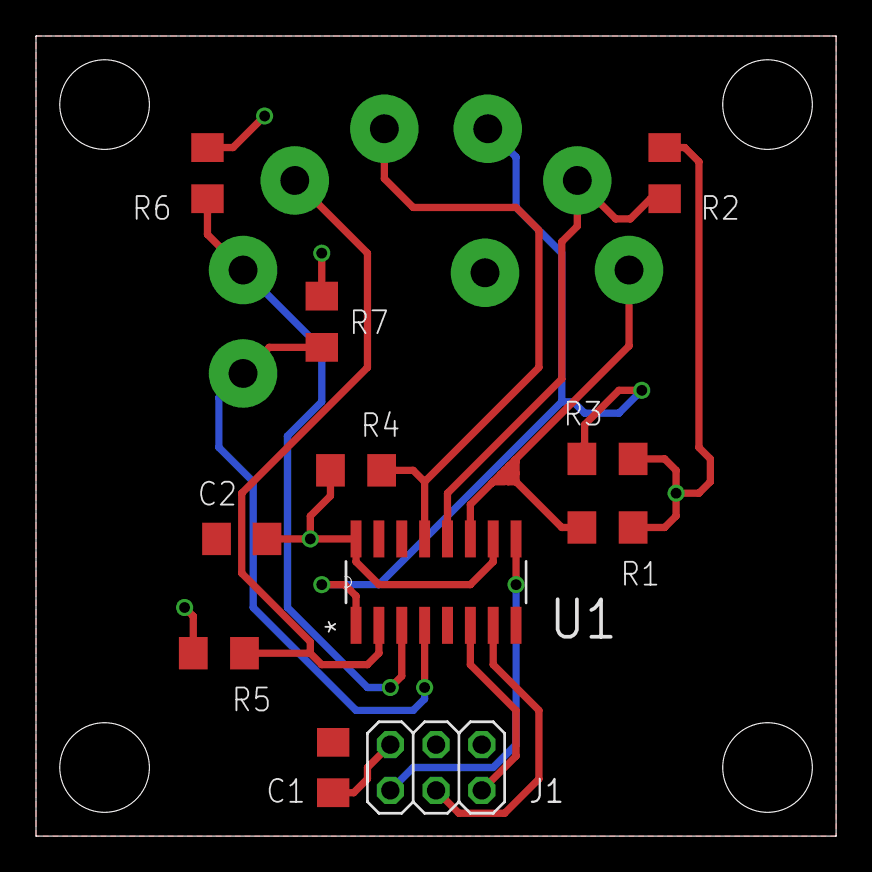
[picture p8: board divchrono-encoder.brd from above]

Board: 2 copper layers, 44.5 x 44.5 mm, 12 parts (1 on the bottom side), 12 nets.
