JEJacobi/divchrono/hw/divchrono-amplifier.brd

## EAGLE design hw/divchrono-amplifier.brd (2016-10-05)

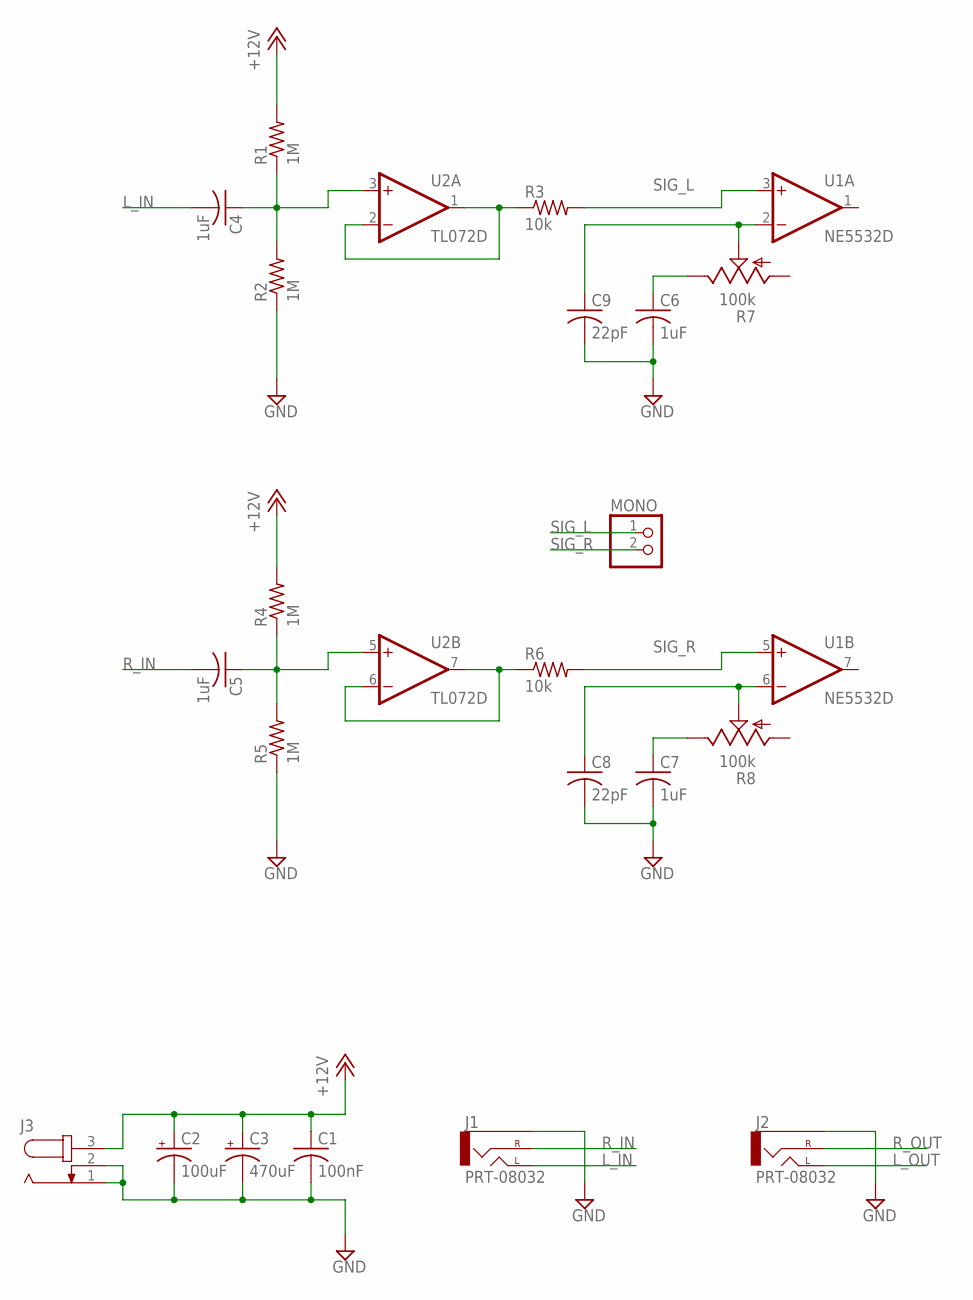
[picture p9: schematic divchrono-amplifier.sch]

Parts:
C1: 100nF; C1206
C2: 100uF; E2,5-6
C3: 470uF; E2,5-6
C4, C5, C6, C7: 1uF; C1206
C8, C9: 22pF; C1206
J1, J2: PRT-08032; AUDIO-JACK
J3: JACK-PLUG0; SPC4077
MONO: PINHD-1X2; 1X02
R1, R2, R4, R5: 1M; R1206
R3, R6: 10k; R1206
R7, R8: 100k; CT6
U1: NE5532D; SO08
U2: TL072D; SO08

Connections:
+12V: C1.1, C2.+, C3.+, J3.3, R1.2, R4.2
GND: C1.2, C2.-, C3.-, C6.2, C7.2, C8.2, C9.2, J1.SLEEVE, J2.SLEEVE, J3.1, J3.2, R2.1, R5.1
L_IN: C4.2, J1.TIP (LEFT)
L_OUT: J2.TIP (LEFT)
unnamed: C4.1, R1.1, R2.2, U2.3 (+IN)
unnamed: R3.1, U2.1 (OUT), U2.2 (-IN)
unnamed: C5.1, R4.1, R5.2, U2.5 (+IN)
unnamed: R6.1, U2.6 (-IN), U2.7 (OUT)
unnamed: C9.1, R7.S, U1.2 (-IN)
unnamed: C8.1, R8.S, U1.6 (-IN)
unnamed: C6.1, R7.E
unnamed: C7.1, R8.E
R_IN: C5.2, J1.RING (RIGHT)
R_OUT: J2.RING (RIGHT)
SIG_L: MONO.1, R3.2, U1.3 (+IN)
SIG_R: MONO.2, R6.2, U1.5 (+IN)
V+: U1.8 (V+), U2.8 (V+)
V-: U1.4 (V-), U2.4 (V-)

Board: 2 copper layers, 23 parts (0 on the bottom side), 16 nets, no tracks yet.
