JEJacobi/divchrono/hw/divchrono-aux.brd

## EAGLE design hw/divchrono-aux.brd (2016-09-26)

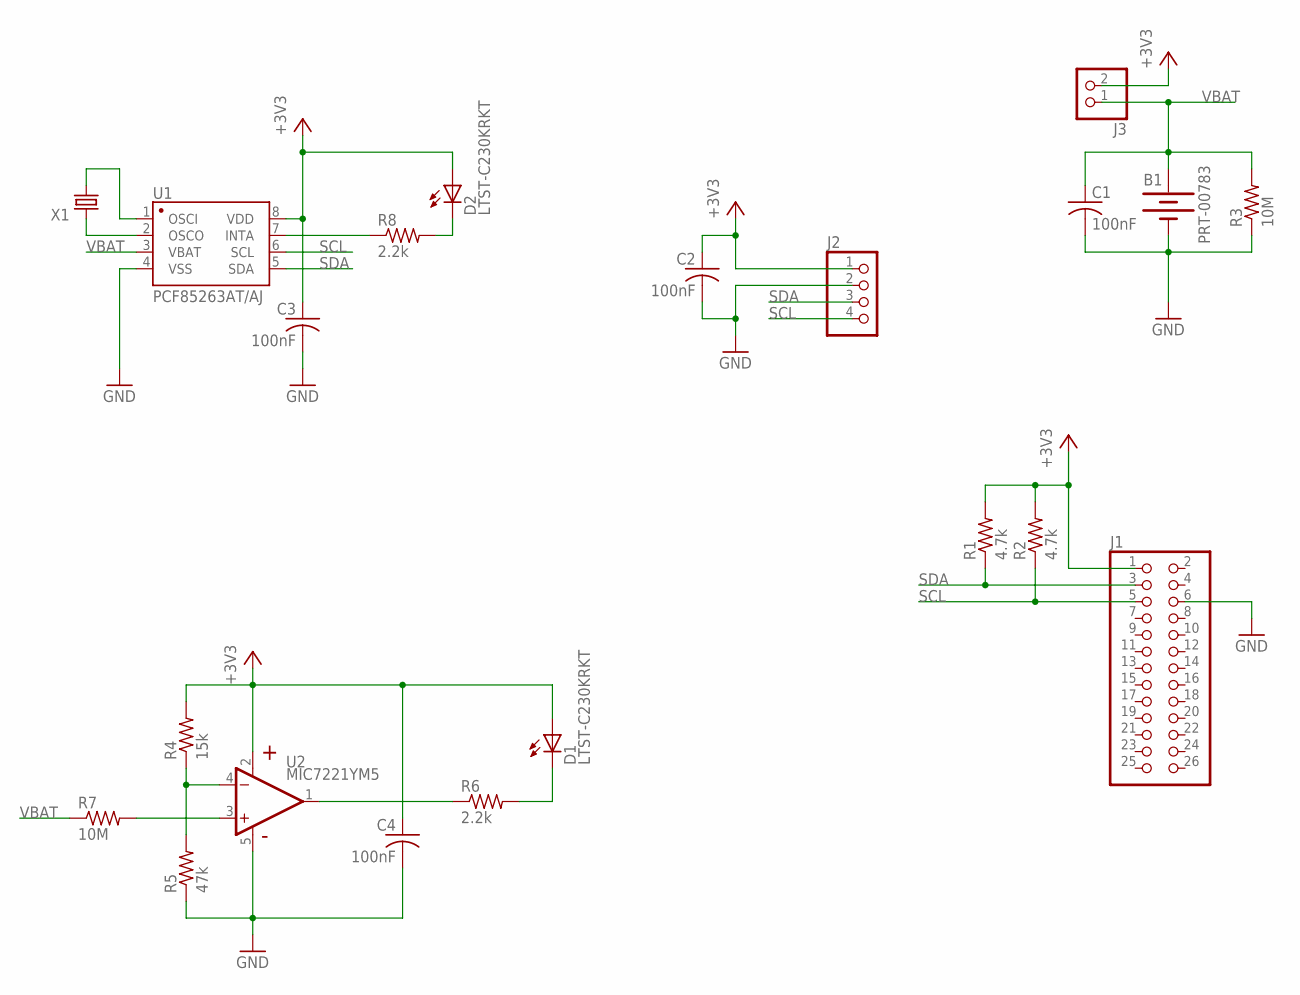
[picture p10: schematic divchrono-aux.sch]

Parts:
B1: PRT-00783; BATTCOM_20MM_PTH
C1, C2, C3, C4: 100nF; C1206
D1, D2: LTST-C230KRKT; CHIPLED_1206
J1: PINHD-2X13; 2X13
J2: PINHD-1X4; 1X04
J3: PINHD-1X2; 1X02
R1, R2: 4.7k; R1206
R3, R7: 10M; R1206
R4: 15k; R1206
R5: 47k; R1206
R6, R8: 2.2k; R1206
U1: PCF85263AT/AJ; SOIC-8
U2: MIC7221YM5; SOT23-5
X1: CRYSTALS-NOGND-WATCH-3X8; WATCH-3X8

Connections:
+3V3: C2.1, C3.1, C4.1, D1.A, D2.A, J1.1, J2.1, J3.2, R1.2, R2.2, R4.2, U1.8 (VDD), U2.2 (V+)
GND: B1.2 (-), C1.2, C2.2, C3.2, C4.2, J1.6, J2.2, R3.1, R5.1, U1.4 (VSS), U2.5 (V-)
unnamed: R6.1, U2.1 (OUT)
unnamed: R4.1, R5.2, U2.4 (-IN)
unnamed: D1.C, R6.2
unnamed: U1.2 (OSCO), X1.1
unnamed: U1.1 (OSCI), X1.2
unnamed: R7.2, U2.3 (+IN)
unnamed: D2.C, R8.2
unnamed: R8.1, U1.7 (INTA)
SCL: J1.5, J2.4, R2.1, U1.6 (SCL)
SDA: J1.3, J2.3, R1.1, U1.5 (SDA)
VBAT: B1.1 (+), C1.1, J3.1, R3.2, R7.1, U1.3 (VBAT)

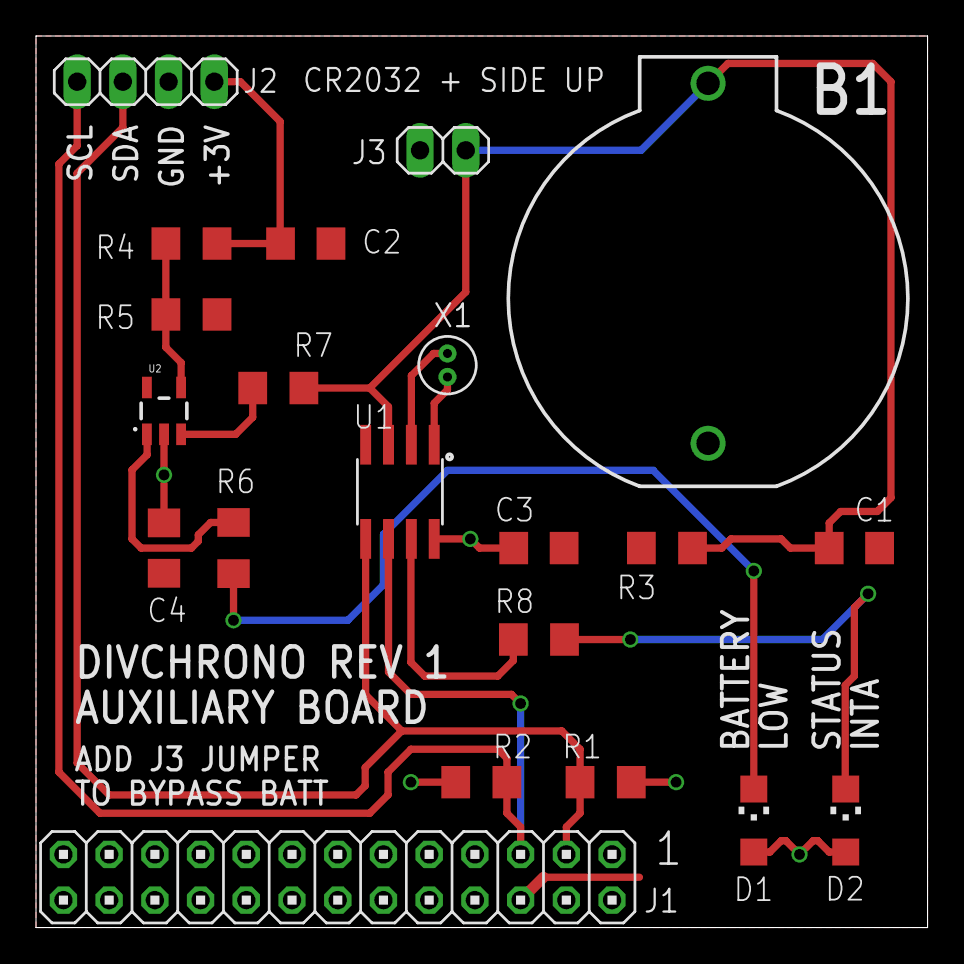
[picture p11: board divchrono-aux.brd from above]

Board: 2 copper layers, 49.5 x 49.5 mm, 21 parts (0 on the bottom side), 13 nets.
