JEJacobi/divchrono/(commit log)

2016-09-26 Initial commit, includes completed auxiliary board and partial master board, as well as placeholder software and audio folder.
    [divchrono-aux.GBL, divchrono-aux.GBO, divchrono-aux.GBP, divchrono-aux.GBS, divchrono-aux.GTL, divchrono-aux.GTO, divchrono-aux.GTP, divchrono-aux.GTS]
2016-10-03 Documentation update, added information on external amplifier, master board, and fixed some typos.
2016-10-03 Added Nixie tube boost converter into schematic, library, and updated documentation for new layout.
    [divchrono-master.brd, divchrono-master.sch]
2016-10-04 Added some pin mapping documentation and updated other files.
2016-10-04 Mirrored pin mappings onto schematic, and fixed two small documentation errors.
    [divchrono-master.brd, divchrono-master.sch]
2016-10-05 Laid out major board connections/pin mappings, and started on framework for encoder and amplifier boards. Minor documentation updates to reflect changes.
    [divchrono-amplifier.brd, divchrono-amplifier.sch, divchrono-encoder.brd, divchrono-encoder.sch, divchrono-master.brd, divchrono-master.sch]
2016-10-05 Minor cleanup, added comments, and fixed style.
    [pins.py, status.py]
2016-10-06 Finished display interface and started master board schematic finalization.
    [divchrono-master.brd, divchrono-master.sch]
2016-10-14 Updated encoder board and documentation for new design using a SN74HC148 encoder instead of a custom PIC.
    [divchrono-encoder.brd, divchrono-encoder.sch]
2016-10-16 Finished initial encoder board schematic and layout. Checked ERC/DRC, updated documentation, and compiled gerbers.
    [divchrono-encoder.GBL, divchrono-encoder.GBO, divchrono-encoder.GBP, divchrono-encoder.GBS, divchrono-encoder.GTL, divchrono-encoder.GTO, divchrono-encoder.GTP, divchrono-encoder.GTS]
2016-10-17 Fixed silkscreen fonts, changed from proportional to vector and rebuilt gerbers.
    [divchrono-encoder.brd]
2016-10-18 Updated BOM with encoder board parts list.
    [divchronoBOM_rev1.ods]
2016-10-20 Final modifications before master board layout. Changed status LED hookup to allow more streamlined part positioning.
    [divchrono-master.brd, divchrono-master.sch]
2016-10-20 Added master board partslist to BOM.
    [divchronoBOM_rev1.ods]
2016-10-24 Finished initial layout for master board, minor schematic and BOM changes.
    [divchrono-master.brd, divchrono-master.sch, divchronoBOM_rev1.ods]
2016-10-24 Made gerber build of master board, added library for warnings, and cleaned up library files into folder.
    [divchrono-master.GBL, divchrono-master.GBO, divchrono-master.GBP, divchrono-master.GBS, divchrono-master.GTL, divchrono-master.GTO, divchrono-master.GTP, divchrono-master.GTS]
2016-11-08 Added PDF versions of schematics.
2016-11-24 Added encoder module and whipped up a quick test for status/encoder routines.
2016-11-24 Updated encoder documentation with new mappings.
